Microcervejaria/Microcervejaria-Controle/PC3/datasheets_e_diagramas/tabela_bitola_fio.PNG

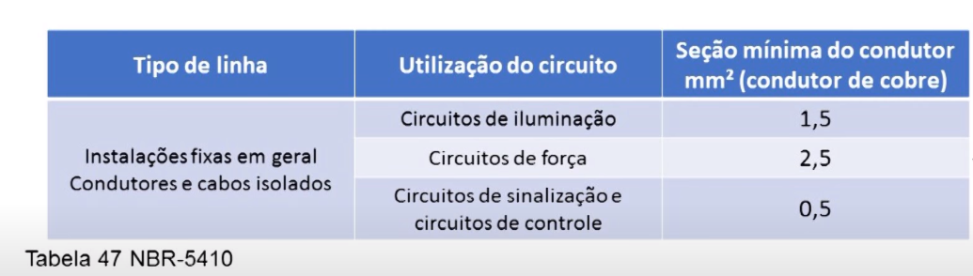
PC3/datasheets_e_diagramas/tabela_bitola_fio.PNG
