Microcervejaria/Microcervejaria-Controle/README.md

# Microcervejaria - Controle
Este é o repositório de controle do projeto da Microcervejaria automatizada Home Beer!
