Microcervejaria/Microcervejaria-Controle/Nobreak/nobreak2.jpg

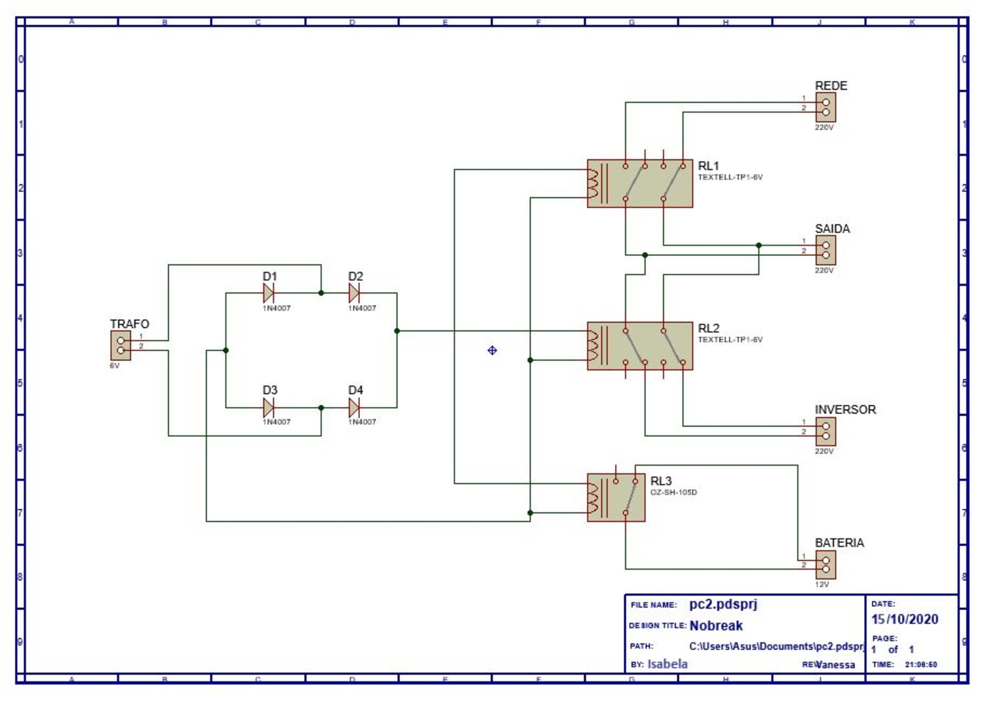
Nobreak/nobreak2.jpg
