Microcervejaria/Microcervejaria-Controle/PC3/datasheets_e_diagramas/datasheet_bomba.PNG

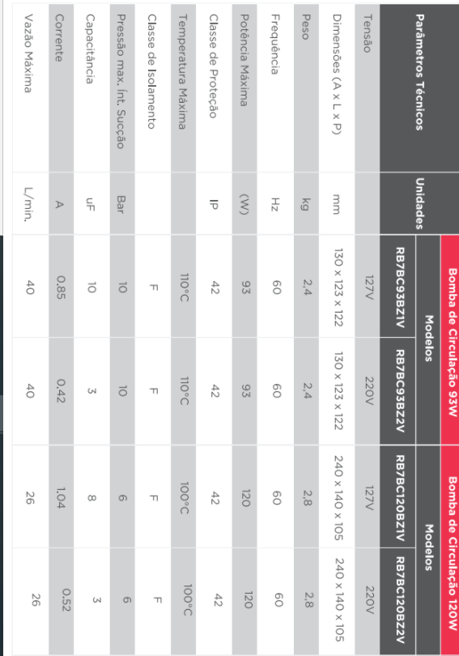
PC3/datasheets_e_diagramas/datasheet_bomba.PNG
