Microcervejaria/Microcervejaria-Controle/PC3/datasheets_e_diagramas/datasheet_fonte_placa_peltier.PNG

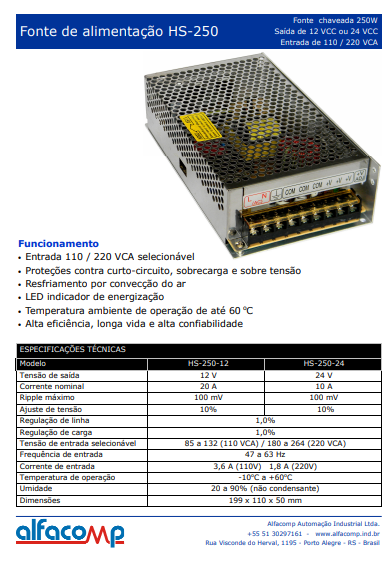
PC3/datasheets_e_diagramas/datasheet_fonte_placa_peltier.PNG
