Microcervejaria/Microcervejaria-Controle/PC3/datasheets_e_diagramas/datasheet_motor_insumos.PNG

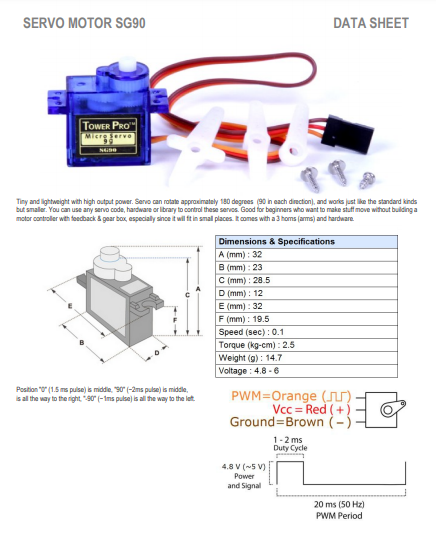
PC3/datasheets_e_diagramas/datasheet_motor_insumos.PNG
