Microcervejaria/Microcervejaria-Controle/PC3/datasheets_e_diagramas/datasheet_rele1.PNG

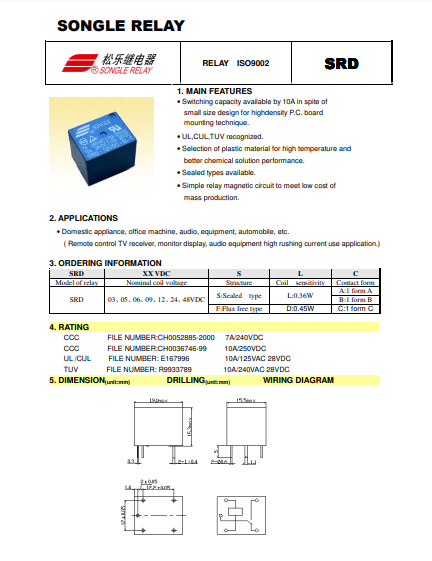
PC3/datasheets_e_diagramas/datasheet_rele1.PNG
