Microcervejaria/Microcervejaria-Controle/PC3/datasheets_e_diagramas/datasheet_sensor_fluxo1.PNG

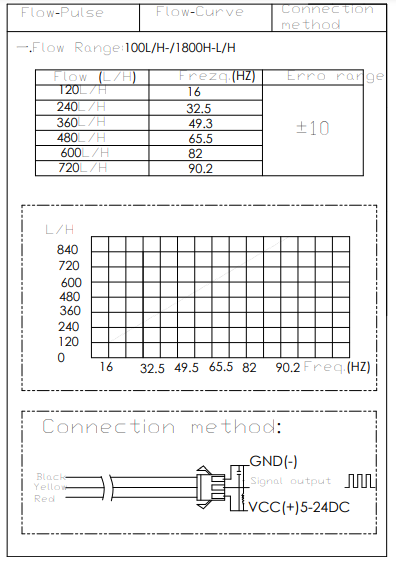
PC3/datasheets_e_diagramas/datasheet_sensor_fluxo1.PNG
