Microcervejaria/Microcervejaria-Controle/PC3/datasheets_e_diagramas/datasheet_sensor_fluxo2.PNG

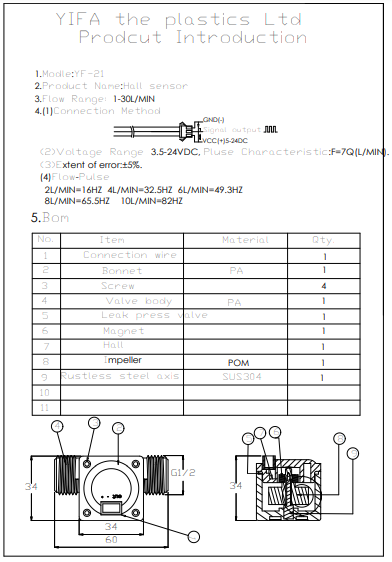
PC3/datasheets_e_diagramas/datasheet_sensor_fluxo2.PNG
