Microcervejaria/Microcervejaria-Controle/PC3/datasheets_e_diagramas/datasheet_sensor_temp.PNG

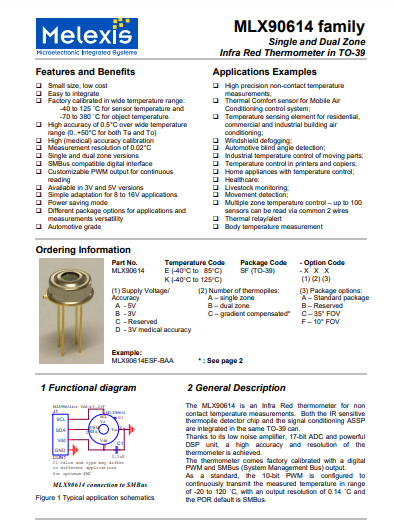
PC3/datasheets_e_diagramas/datasheet_sensor_temp.PNG
