Microcervejaria/Microcervejaria-Controle/PC3/datasheets_e_diagramas/datasheet_valvula_sol2.PNG

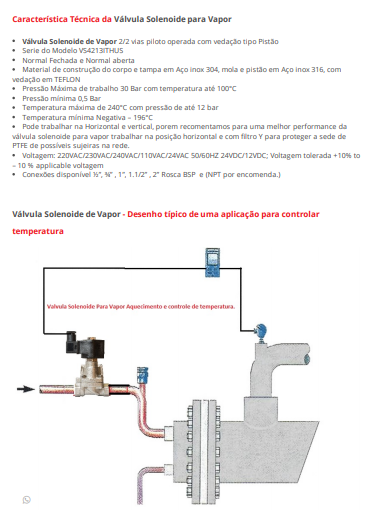
PC3/datasheets_e_diagramas/datasheet_valvula_sol2.PNG
