Microcervejaria/Microcervejaria-Controle/PC3/datasheets_e_diagramas/diagrama de pinos rasp.jpg

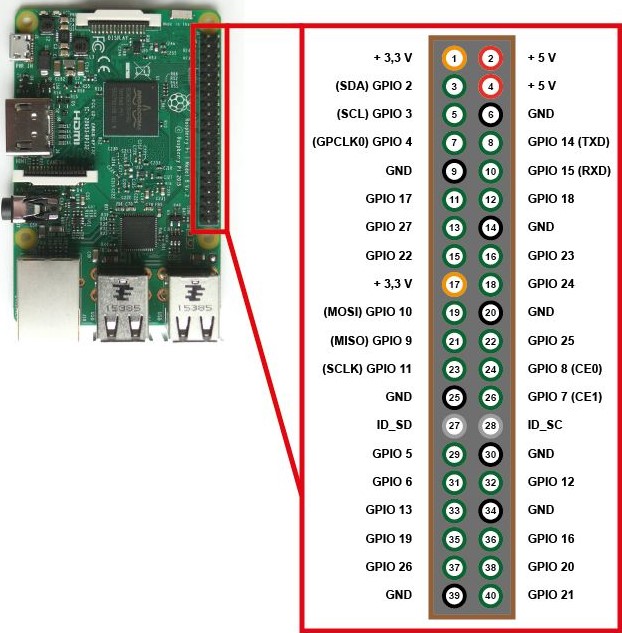
PC3/datasheets_e_diagramas/diagrama de pinos rasp.jpg
