Microcervejaria/Microcervejaria-Controle/PC3/projetos_fritzing/3_Sensor_Conection_MLX90614_Esquemático.jpg

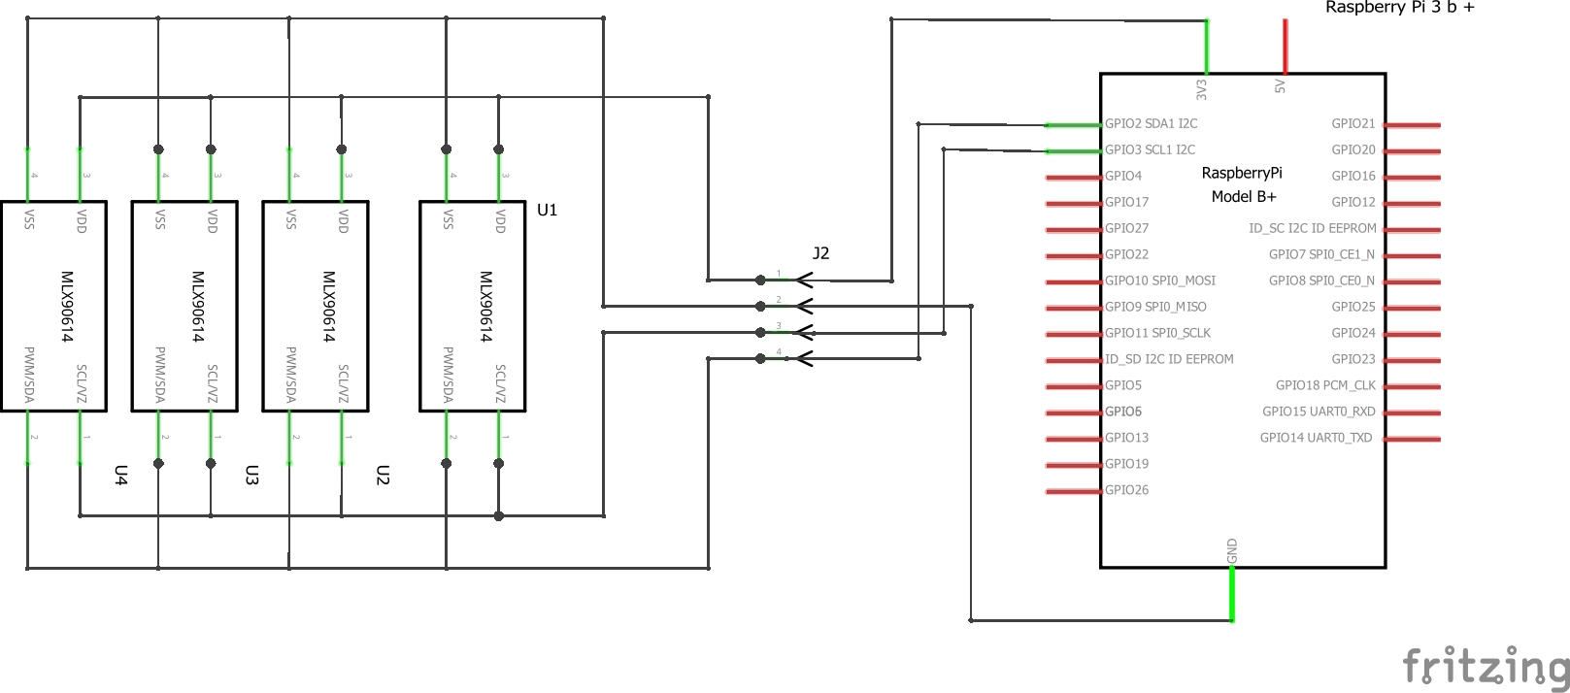
PC3/projetos_fritzing/3_Sensor_Conection_MLX90614_Esquemático.jpg
