Microcervejaria/Microcervejaria-Controle/PC3/projetos_fritzing/3_Sensor_Fluxo_Agua_Esquemático.png

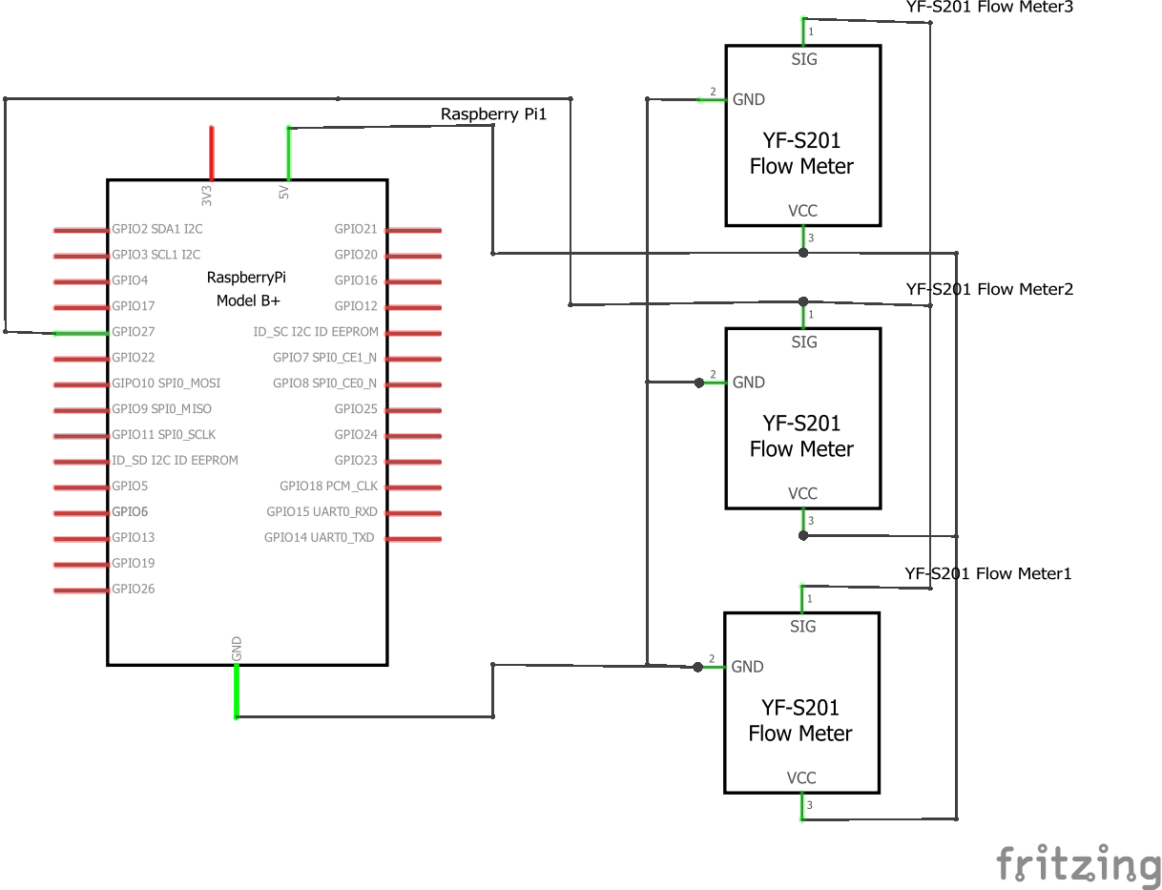
PC3/projetos_fritzing/3_Sensor_Fluxo_Agua_Esquemático.png
