Microcervejaria/Microcervejaria-Controle/PC3/projetos_fritzing/Conexao_all.jpg

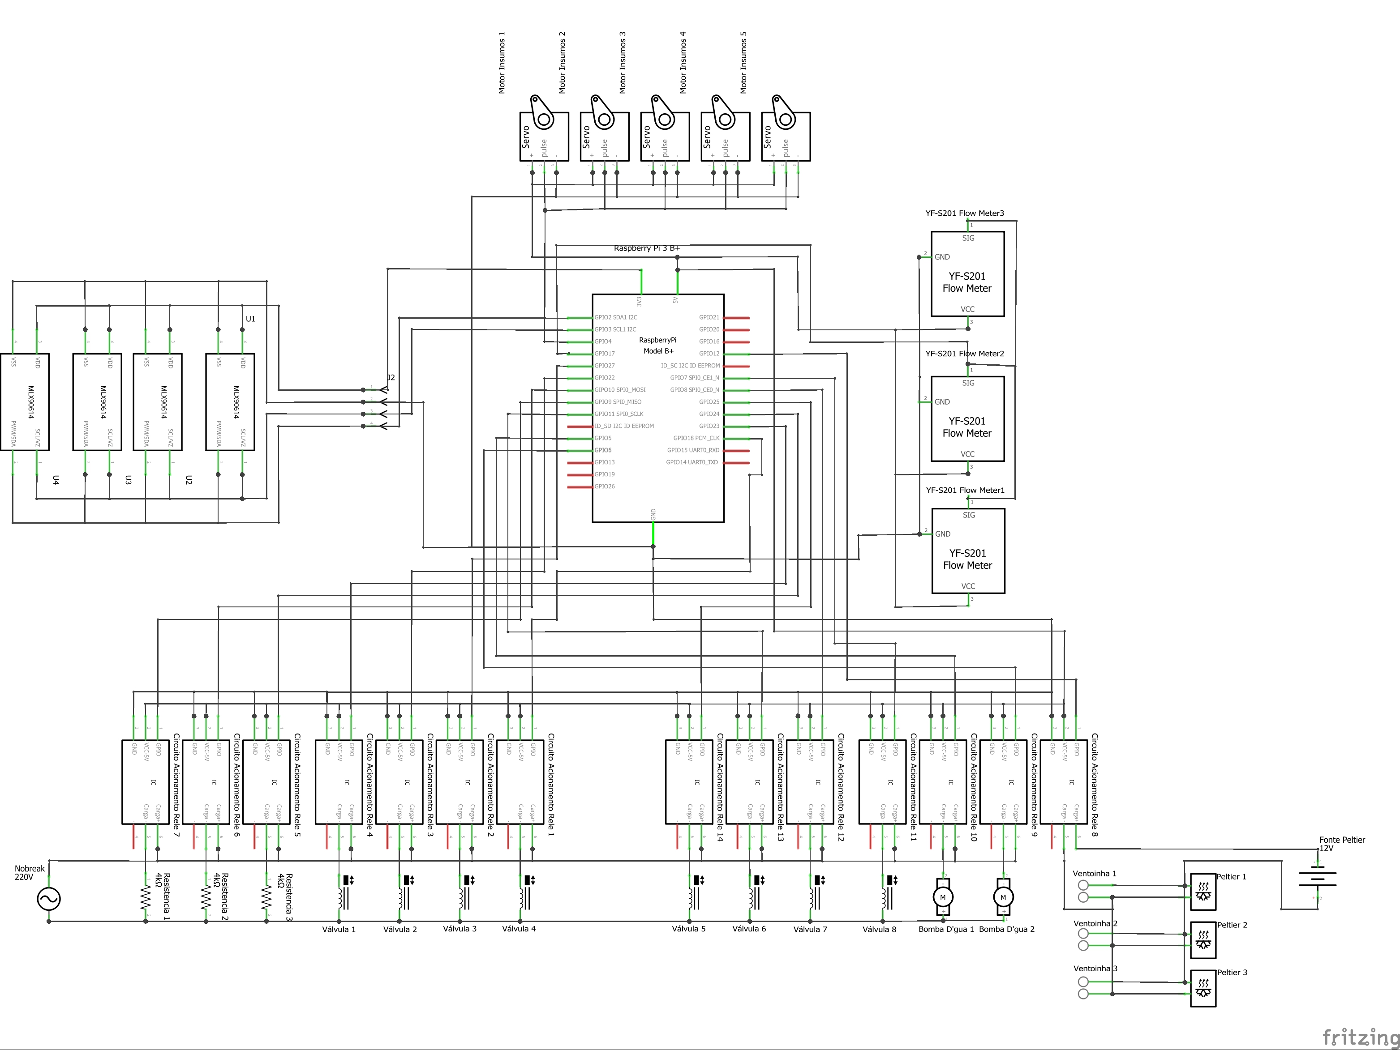
PC3/projetos_fritzing/Conexao_all.jpg
