Microcervejaria/Microcervejaria-Controle/PC3/projetos_fritzing/Esquematico_Conec_Sistema_Aquisicao_Esquemático.png

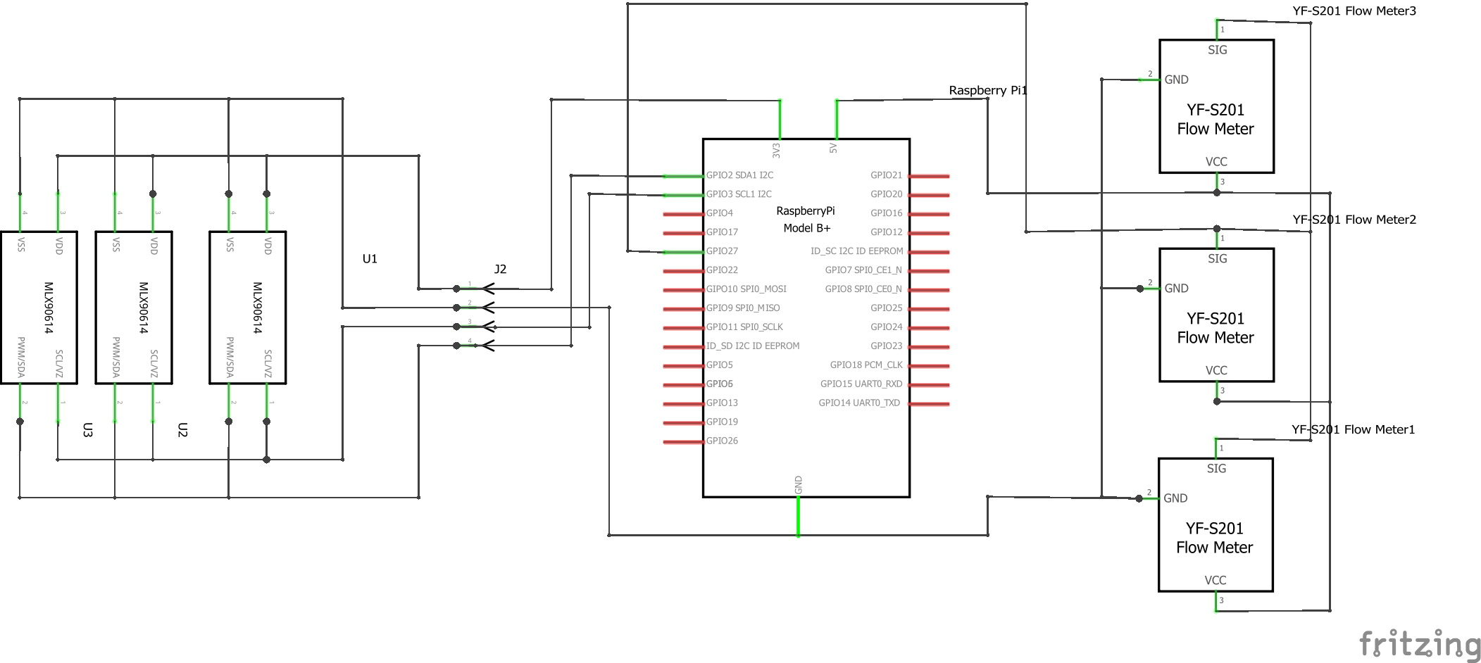
PC3/projetos_fritzing/Esquematico_Conec_Sistema_Aquisicao_Esquemático.png
