Microcervejaria/Microcervejaria-Controle/PC3/projetos_fritzing/sensor_temp_Esquemático.png

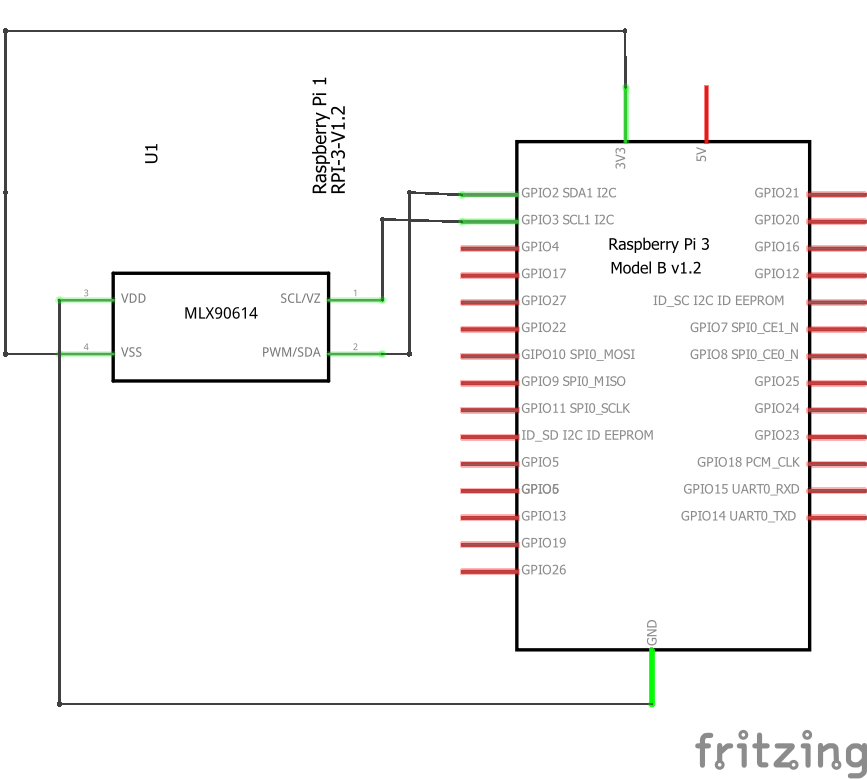
PC3/projetos_fritzing/sensor_temp_Esquemático.png
