Microcervejaria/Microcervejaria-Controle/PC3/projetos_proteus/pcb_acionamento_rele.PNG

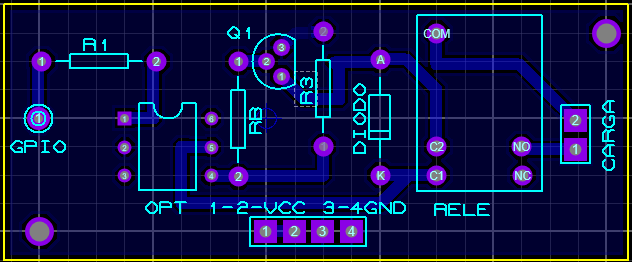
PC3/projetos_proteus/pcb_acionamento_rele.PNG
