Microcervejaria/Microcervejaria-Controle/PC3/projetos_proteus/pcb_circuito_acionamento.PNG

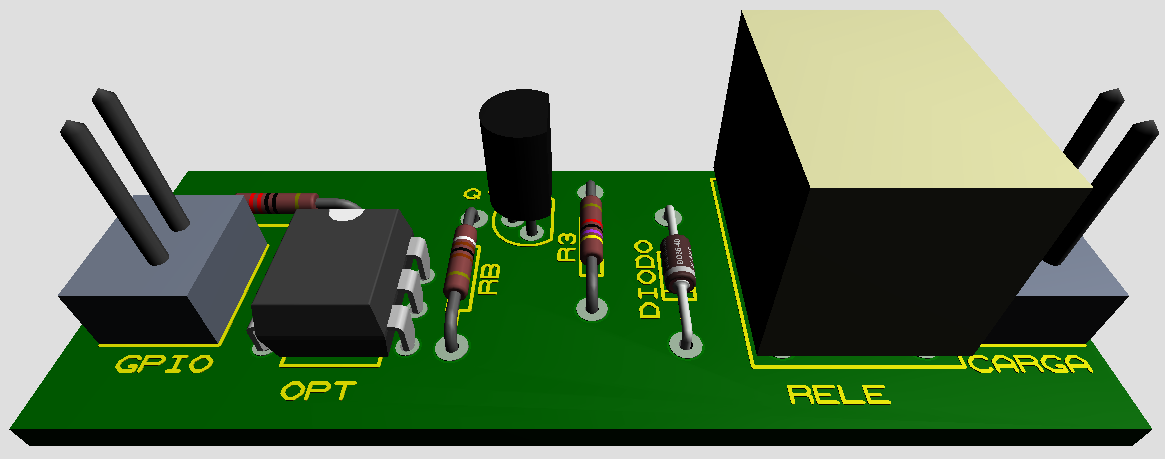
PC3/projetos_proteus/pcb_circuito_acionamento.PNG
