Microcervejaria/Microcervejaria-Controle/PC3/projetos_proteus/pcb_nobreak.PNG

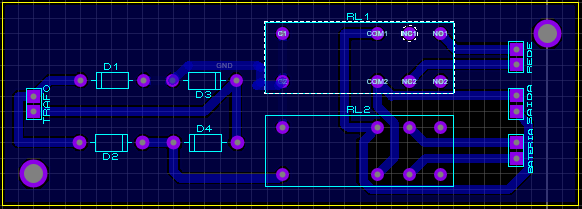
PC3/projetos_proteus/pcb_nobreak.PNG
