Microcervejaria/Microcervejaria-Controle/PC3/projetos_proteus/Circuito_Acionamento_Rele.STEP

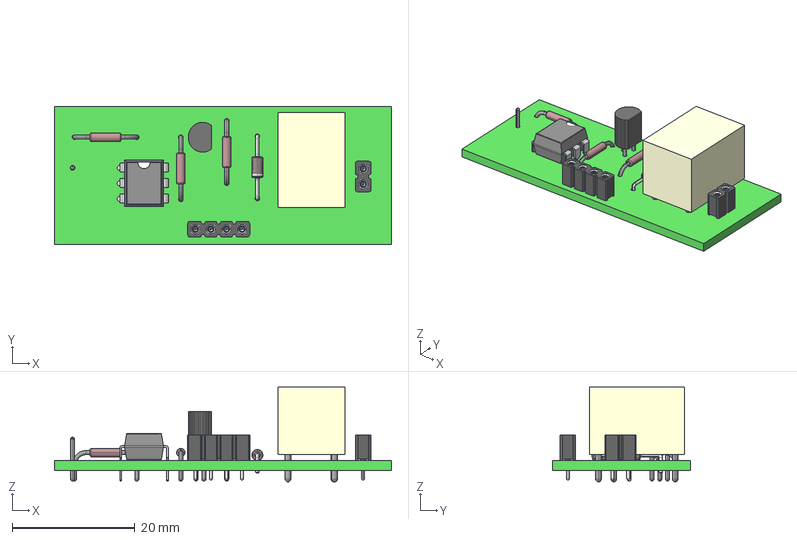
[picture p29: CAD file, 2020-11-20]
PC3/projetos_proteus/Circuito_Acionamento_Rele.STEP
55.0 x 22.5 x 15.5 mm
Layer_1
Pin_1 x 6
Pin_2 x 5
Pin_3 x 2
Pin_4
Pin_5
