Microcervejaria/Microcervejaria-Controle/PC3/projetos_proteus/pc2/pc2.STEP

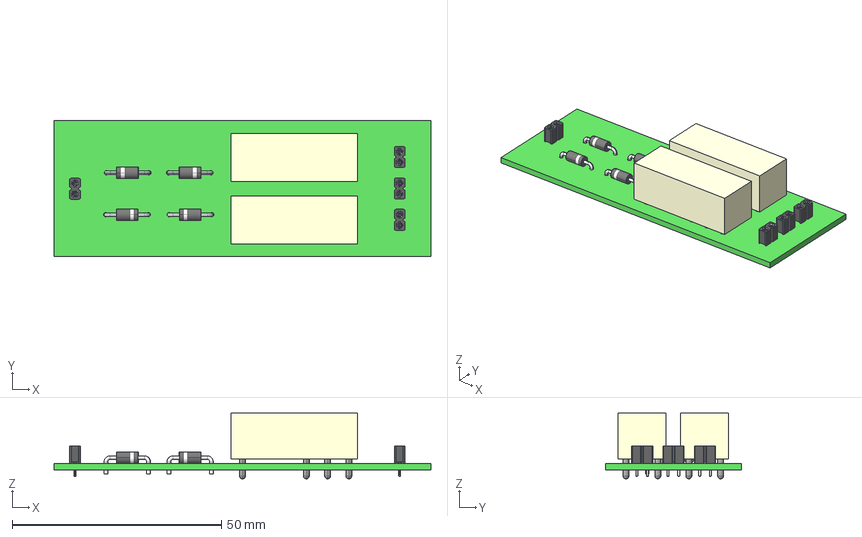
[picture p30: CAD file, 2020-11-20]
PC3/projetos_proteus/pc2/pc2.STEP
90.0 x 32.5 x 15.7 mm
Layer_1
Pin_1 x 2
Pin_2 x 2
Pin_3 x 2
Pin_4 x 2
Pin_5 x 2
Pin_6 x 2
Pin_7 x 2
Pin_8 x 2
