Microcervejaria/Microcervejaria-Controle/(list of files, cad)

Other CAD files:
PC3/projetos_proteus/pc2/Fonte_peltier.STEP
