Microcervejaria/Microcervejaria-Controle/PC3/projetos_proteus/circuito_-teste.pdf

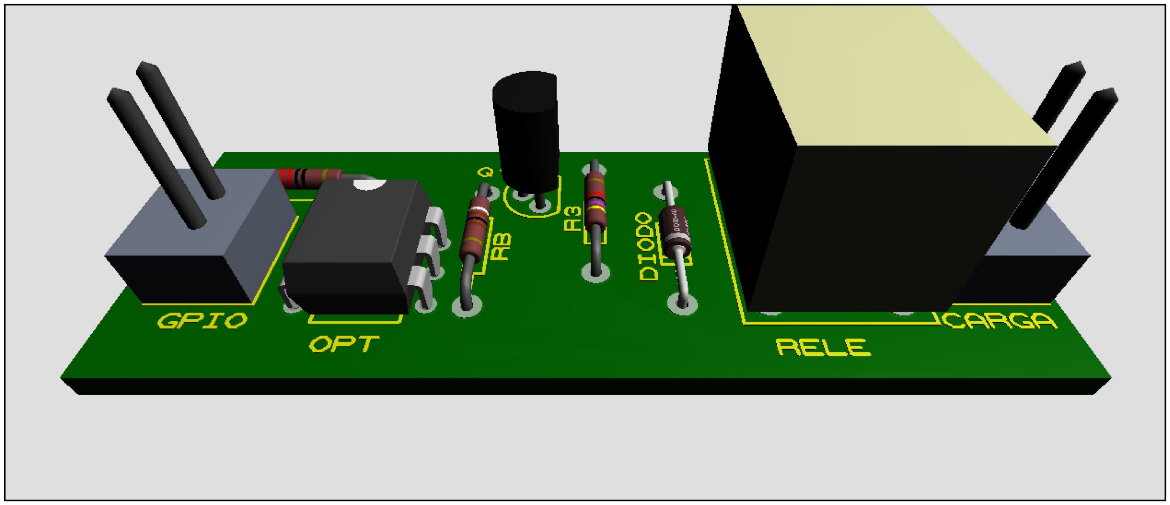
[picture p31: figure]
