Microcervejaria/Microcervejaria-Controle/PC3/projetos_fritzing/all_Conections_Componentes.pdf

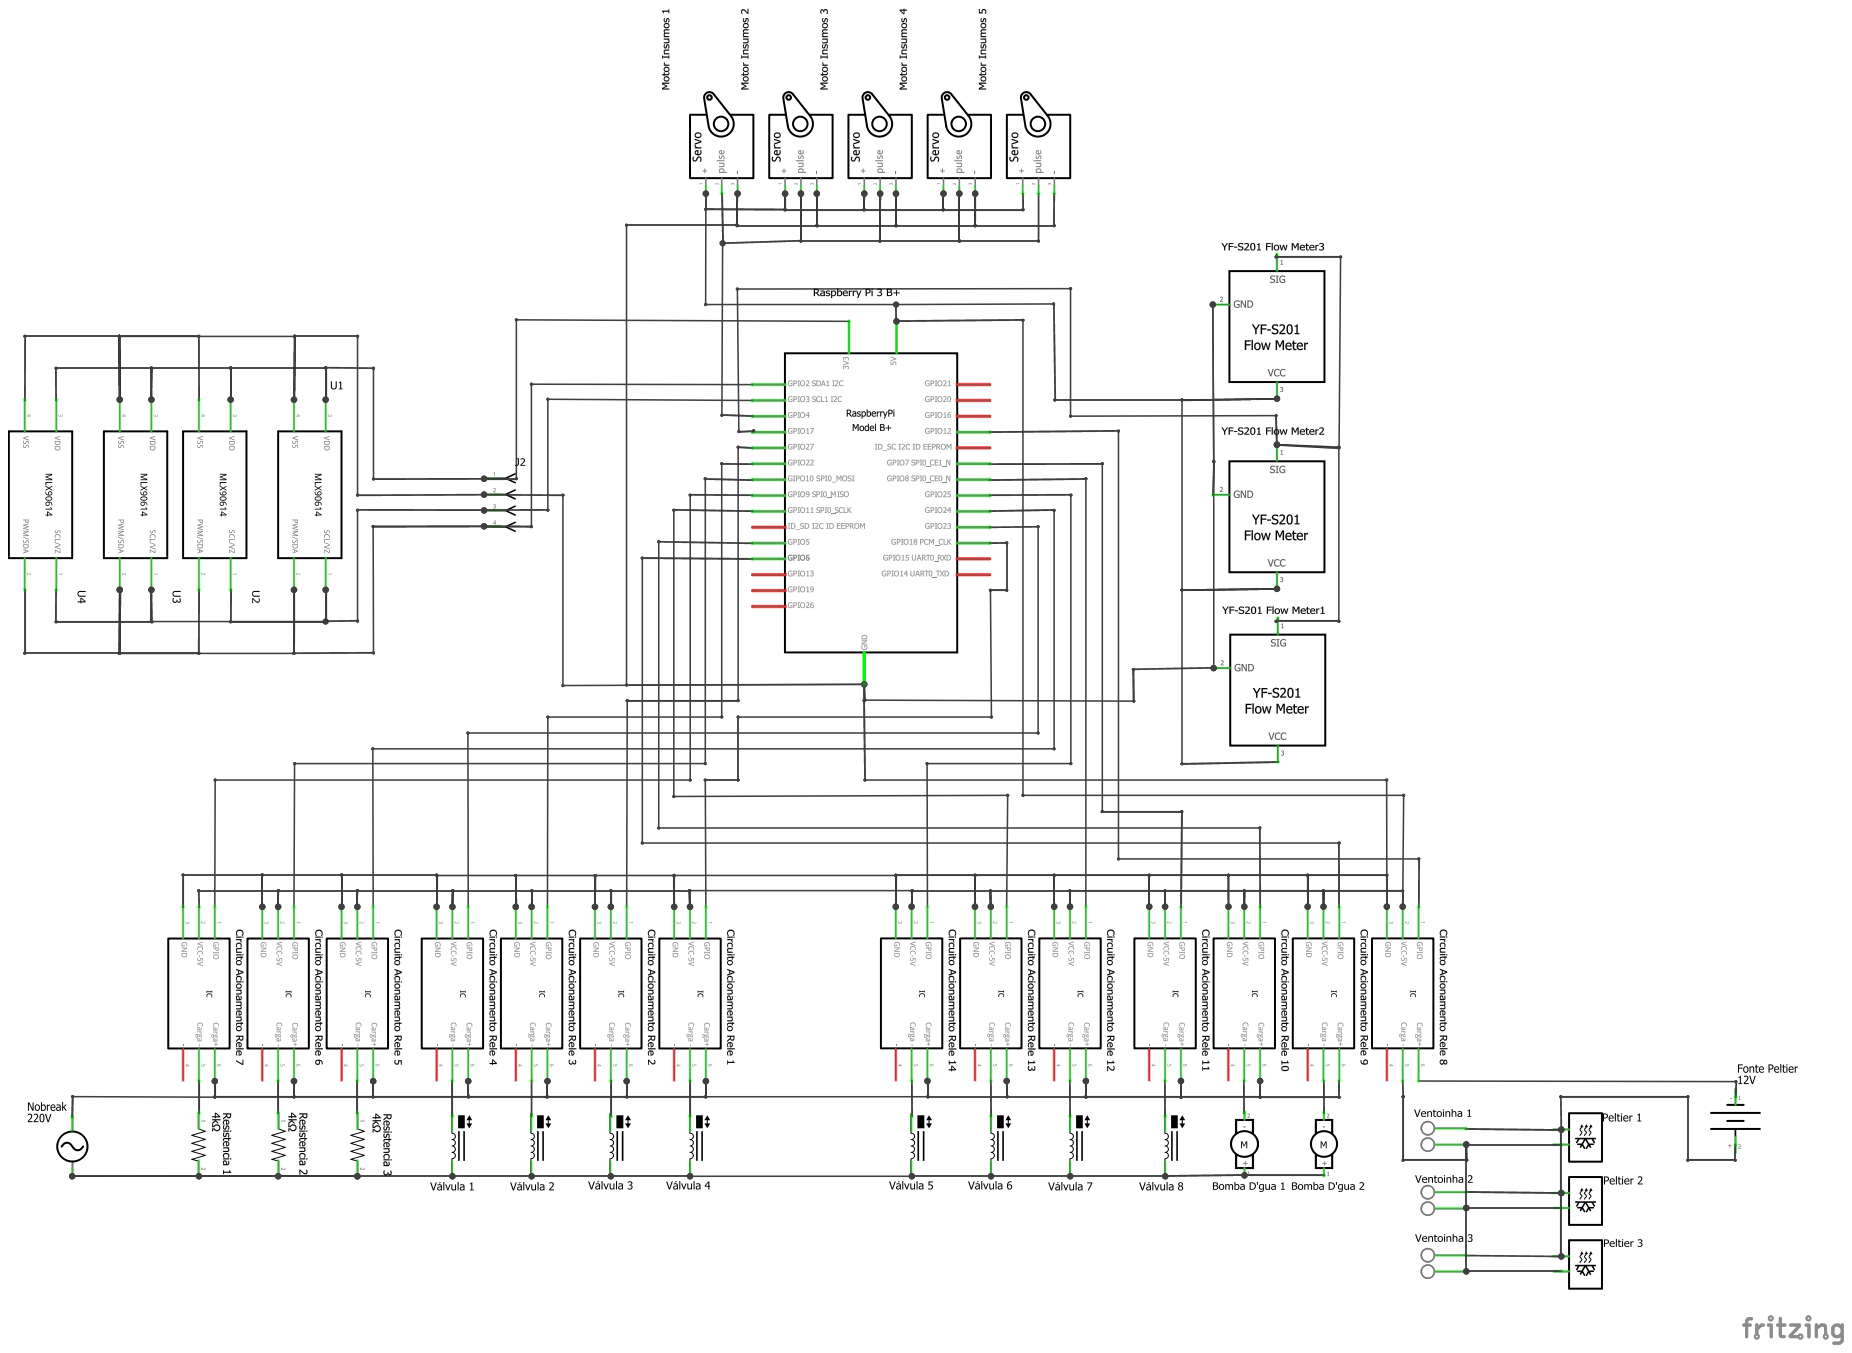
[picture p32: page 1]
