Microcervejaria/Microcervejaria-Controle/PC3/projetos_fritzing/all_Sensor_Conection_MLX90614_etch_silk_bottom_mirror.pdf

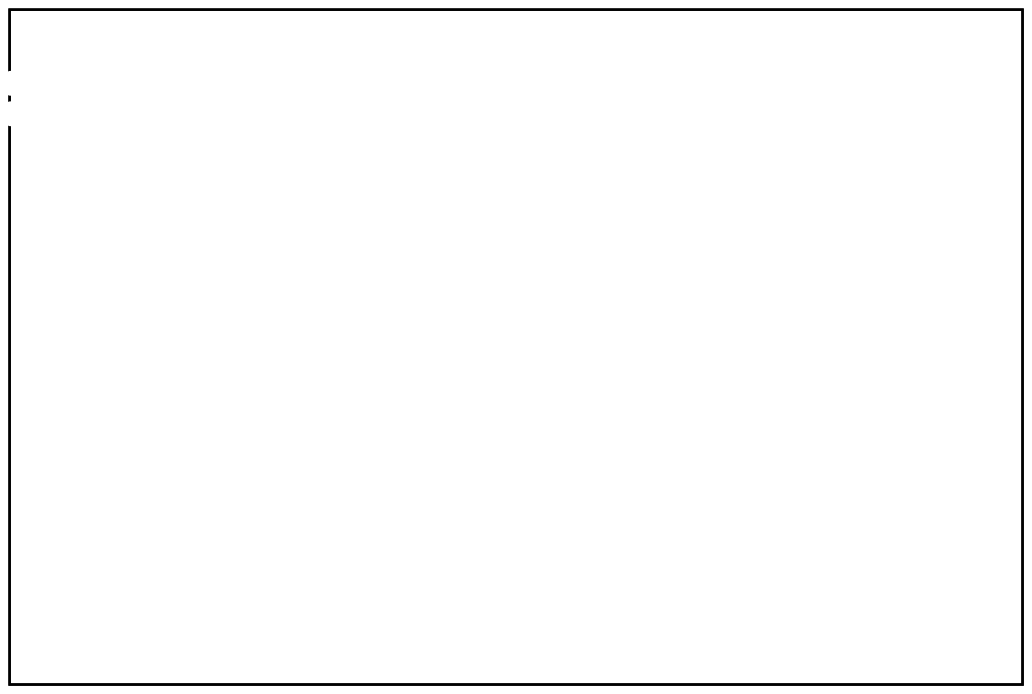
[picture p33: page 1]
