Microcervejaria/Microcervejaria-Controle/(list of files, drawings)

Other design files:
PC3/projetos_fritzing/3_Sensor_Conection_MLX90614.fzz
PC3/projetos_fritzing/all_Sensor_Conection_MLX90614.fzz
PC3/projetos_fritzing/Circuito_Acionamento_Rele.fzz
PC3/projetos_fritzing/Esquematico_Conec_Sistema_Aquisicao.fzz
PC3/projetos_fritzing/Fonte_reguladora_peltier.fzz
PC3/projetos_fritzing/sensor_fluxo.fzz
PC3/projetos_fritzing/Sensor_Fluxo_Agua.fzz
PC3/projetos_fritzing/sensor_temp.fzz
PC3/projetos_proteus/Circuito_Acionamento_Rele.pdsprj
PC3/projetos_proteus/fonte_reguladora_12v.pdsprj
PC3/projetos_proteus/pc2/pc2.pdsprj
